Gregification/wm-top/enviroment/notes/resources.md

1. [How to setup the DDR configuration](https://wiki.st.com/stm32mpu/wiki/How_to_setup_the_DDR_configuration)
    - only how to apply configuraiton, no info on how to use DDR tool

1. [How to create your own machine](https://wiki.st.com/stm32mpu/wiki/How_to_create_your_own_machine)
