Gregification/wm-top/cad/kicad/ProcessorBoard_STM32MP153/related documents/IS43LD16320A-25BLI timing notes.pdf

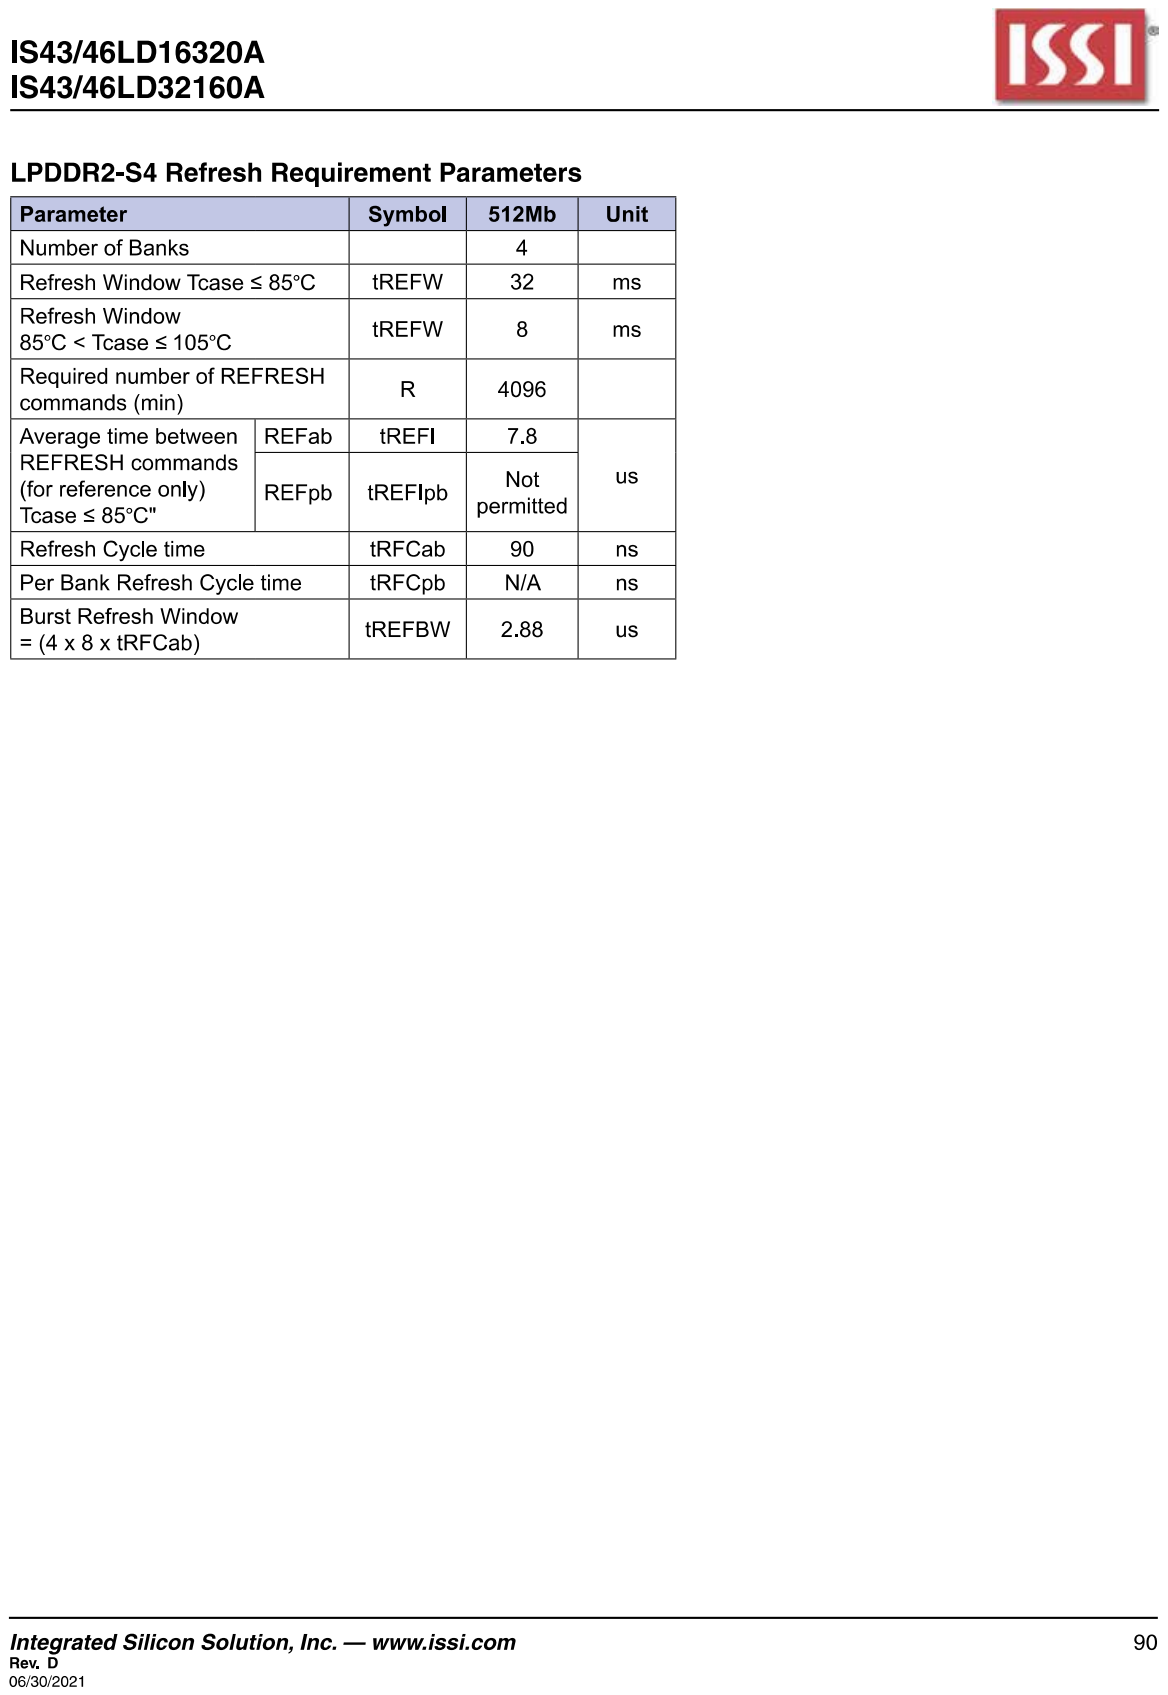
[picture p4: page 1]

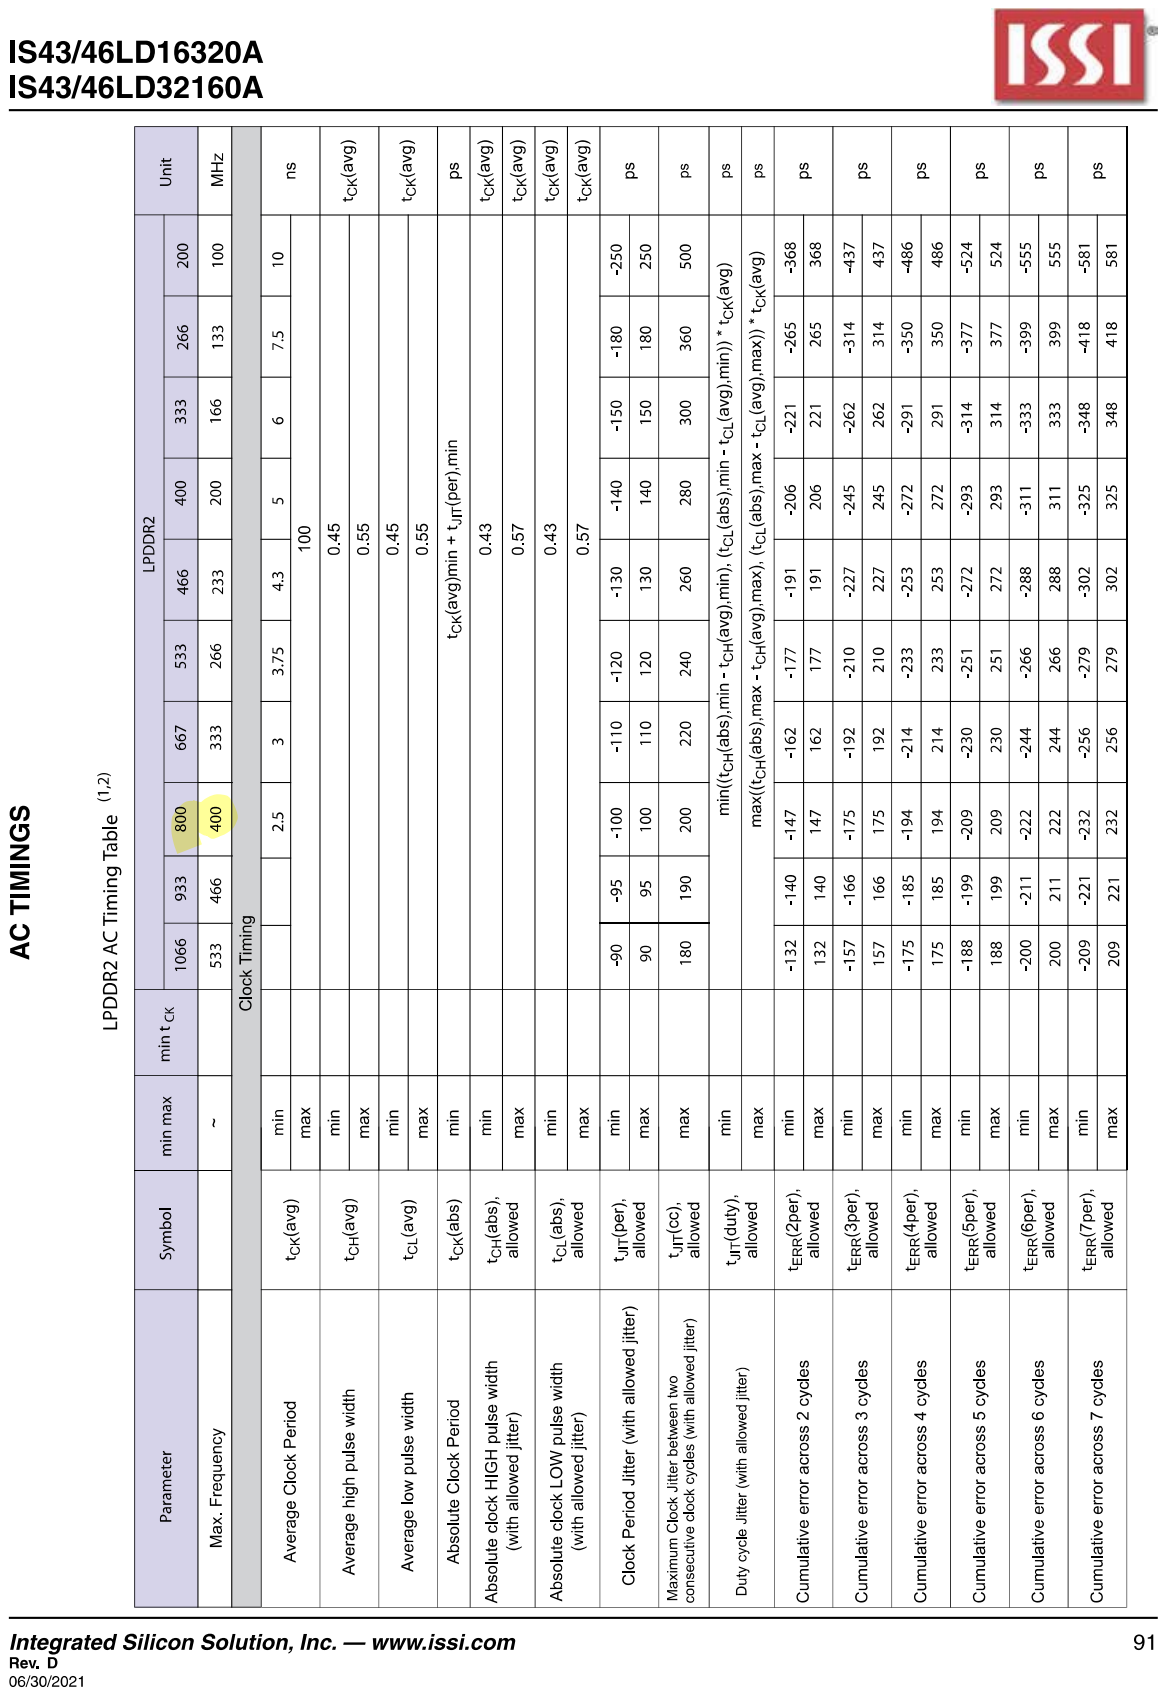
[picture p5: page 2]

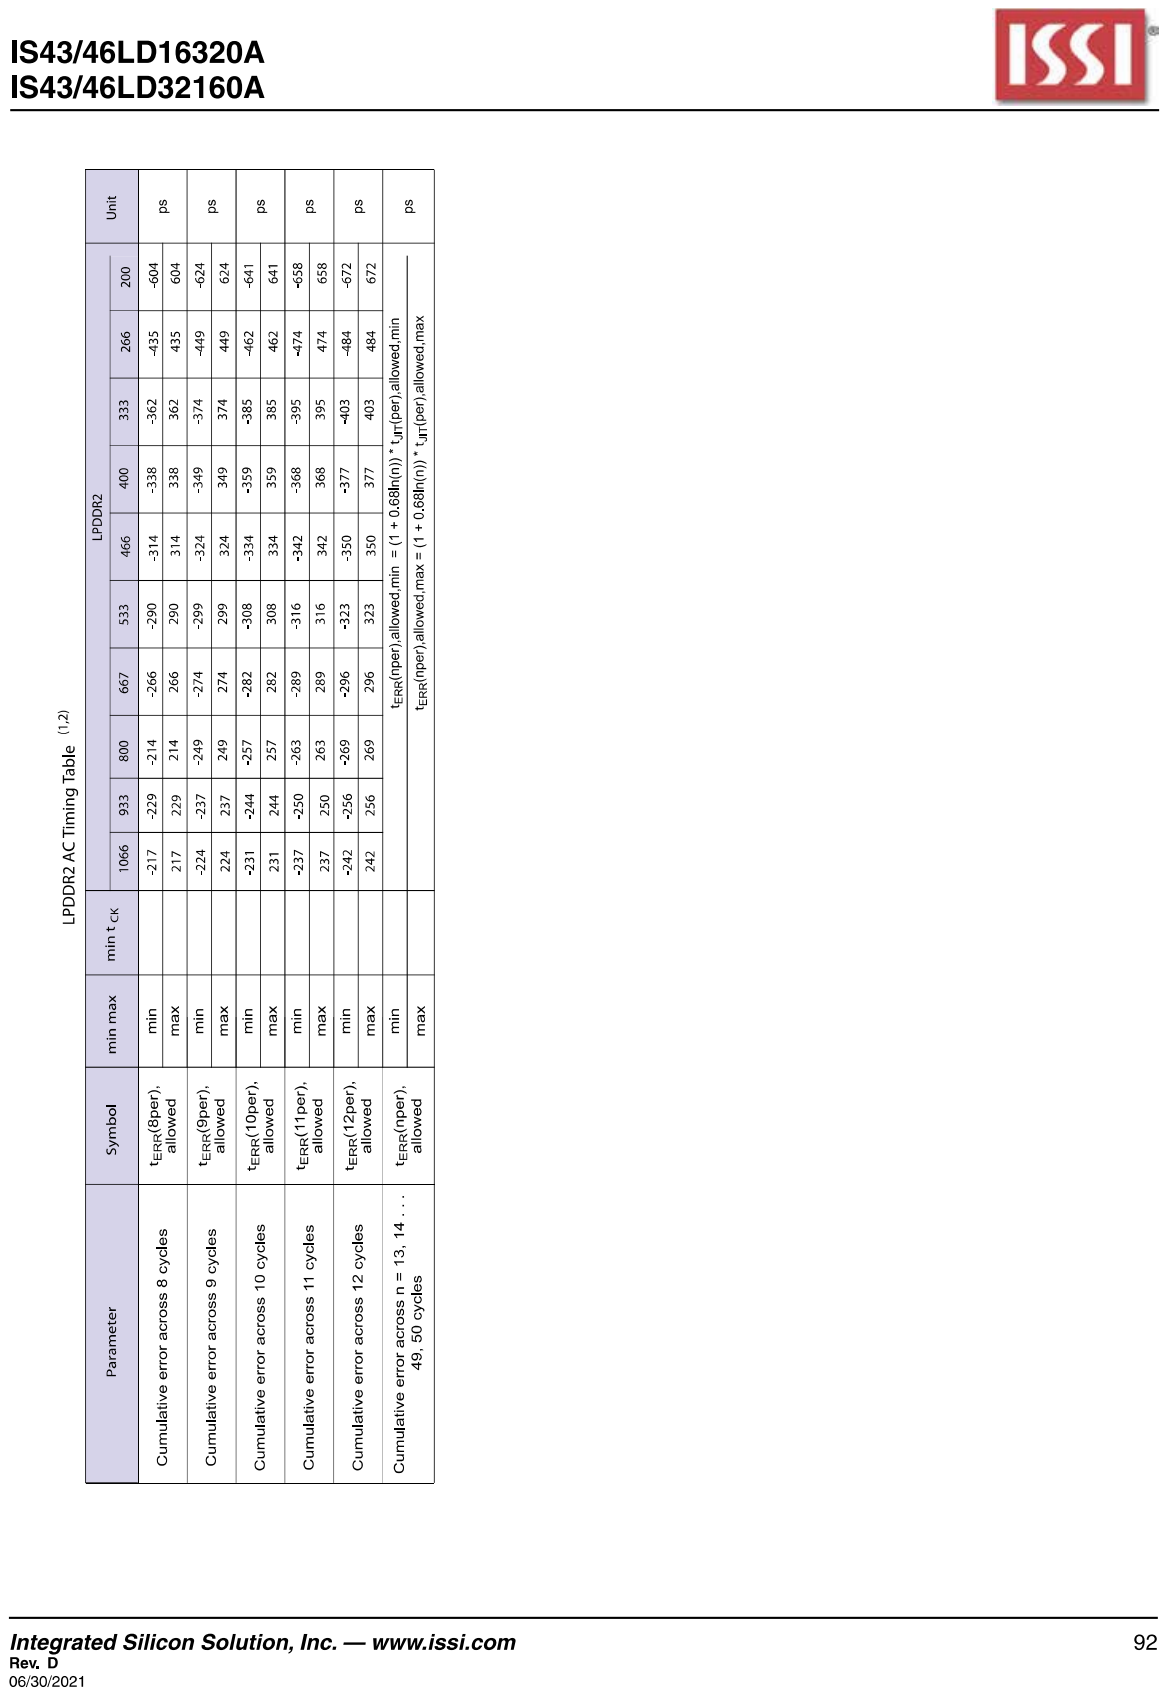
[picture p6: page 3]

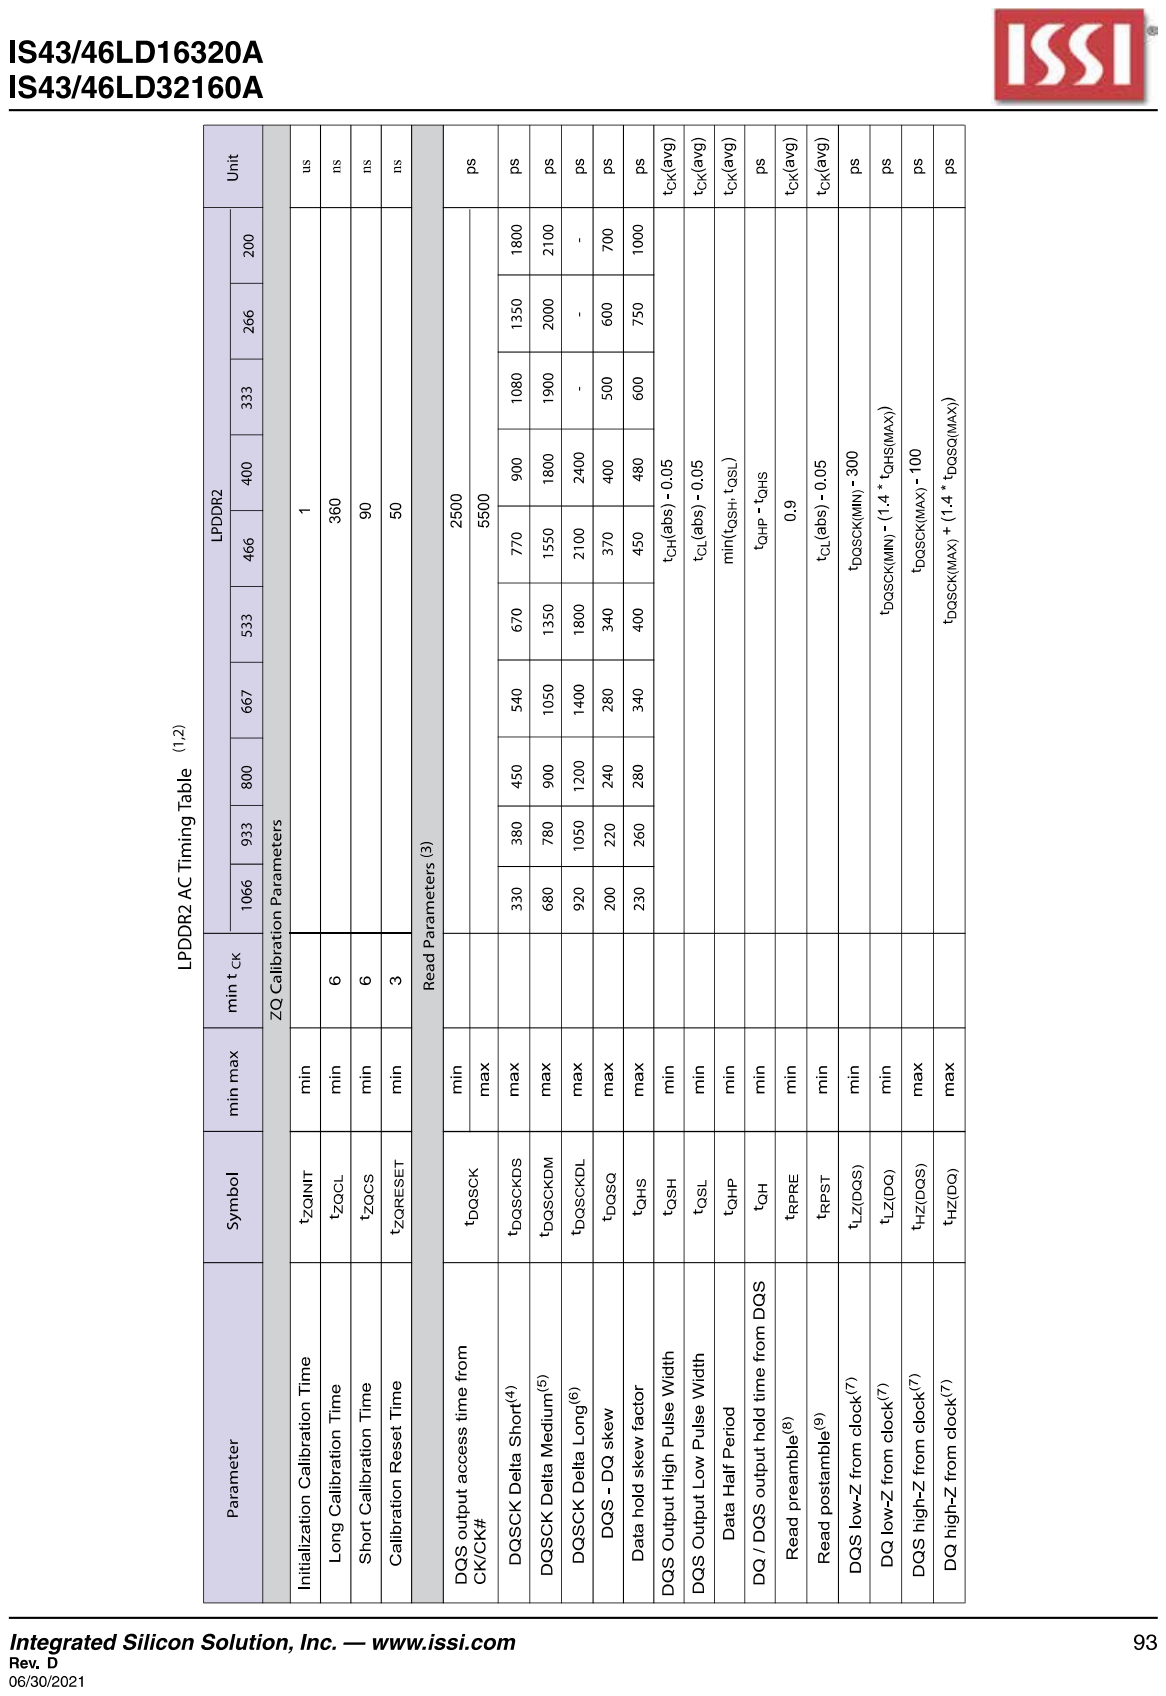
[picture p7: page 4]

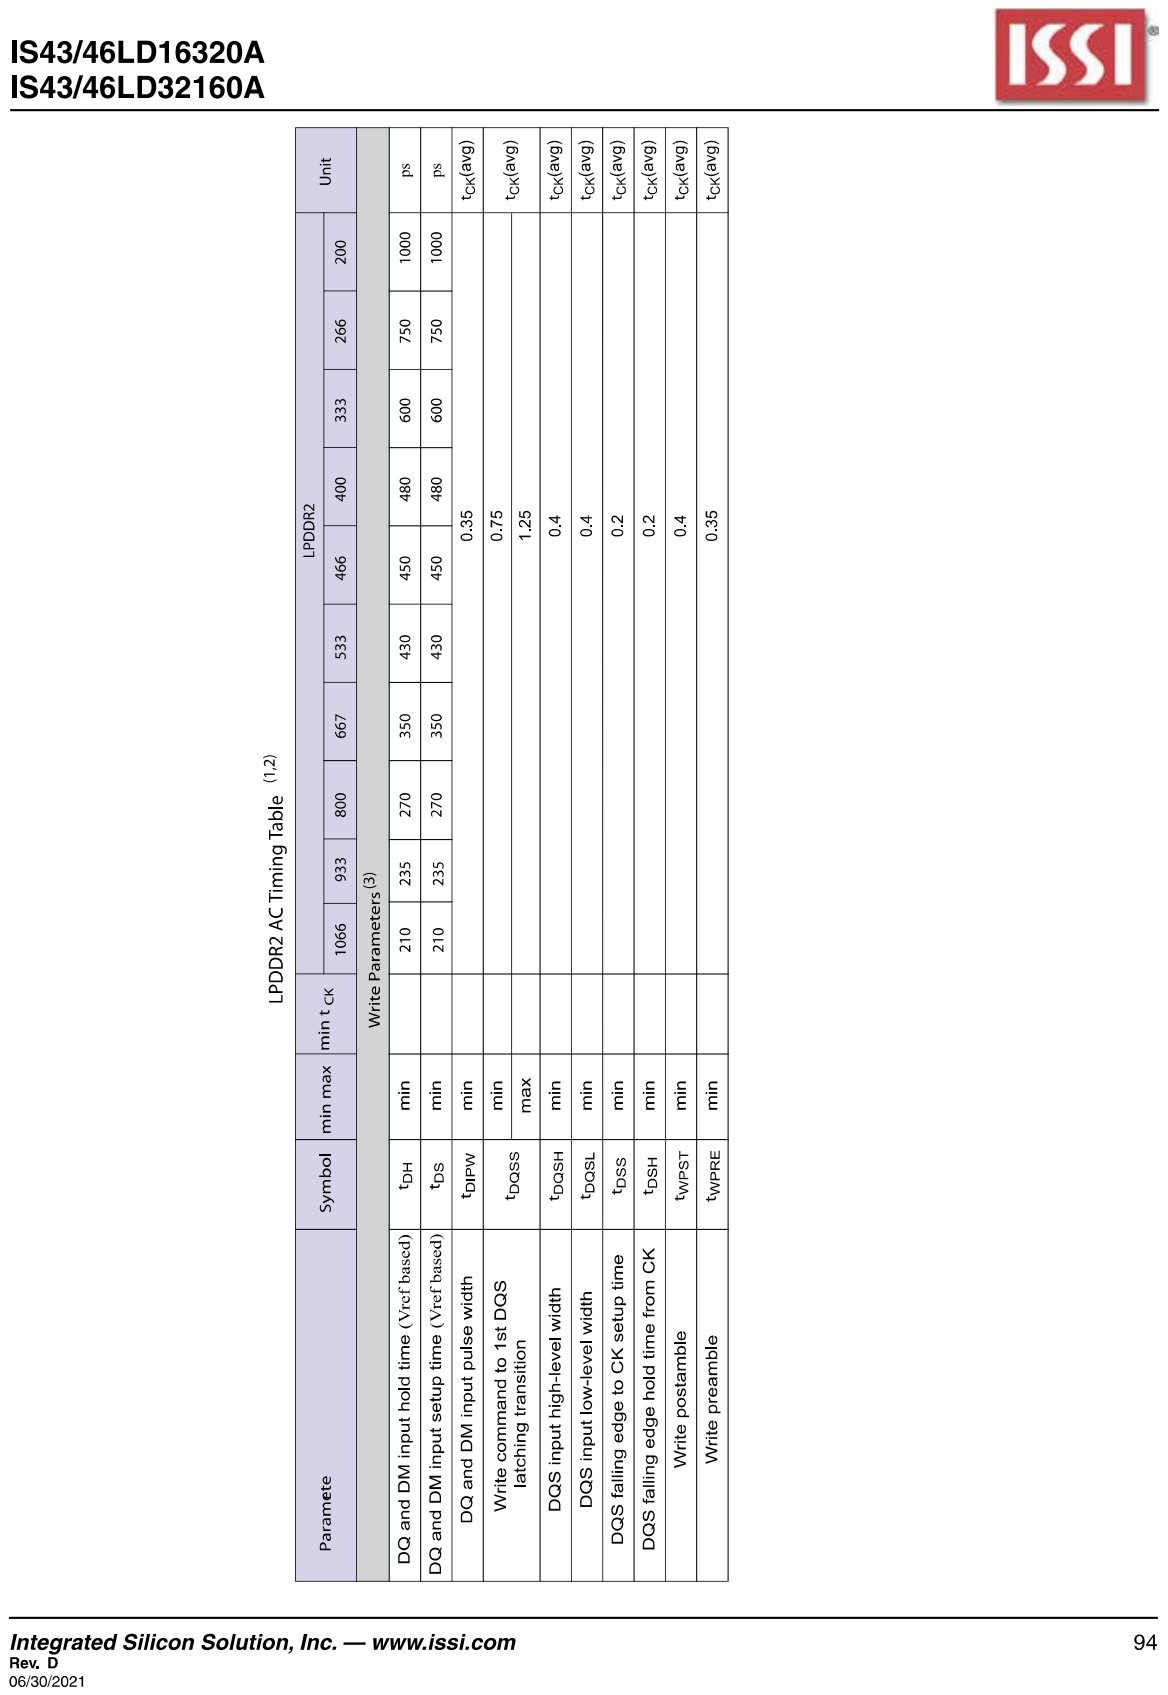
[picture p8: page 5]

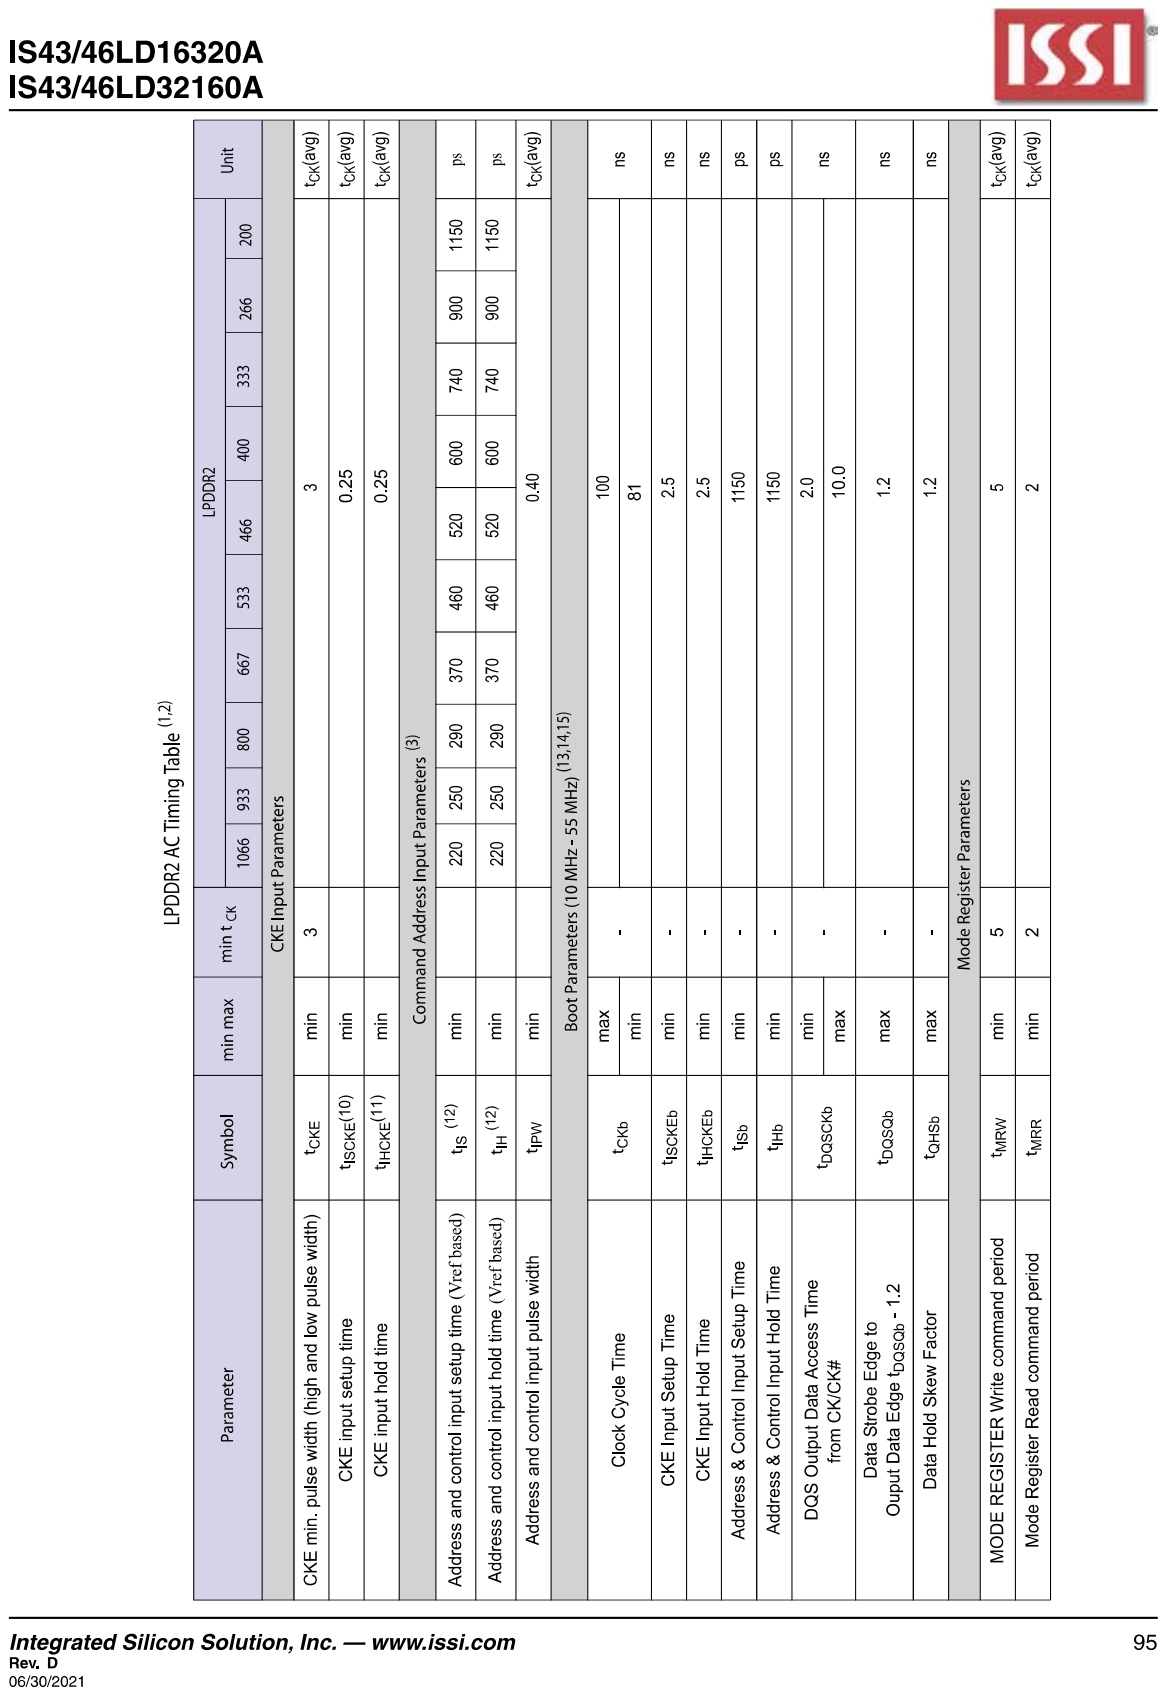
[picture p9: page 6]

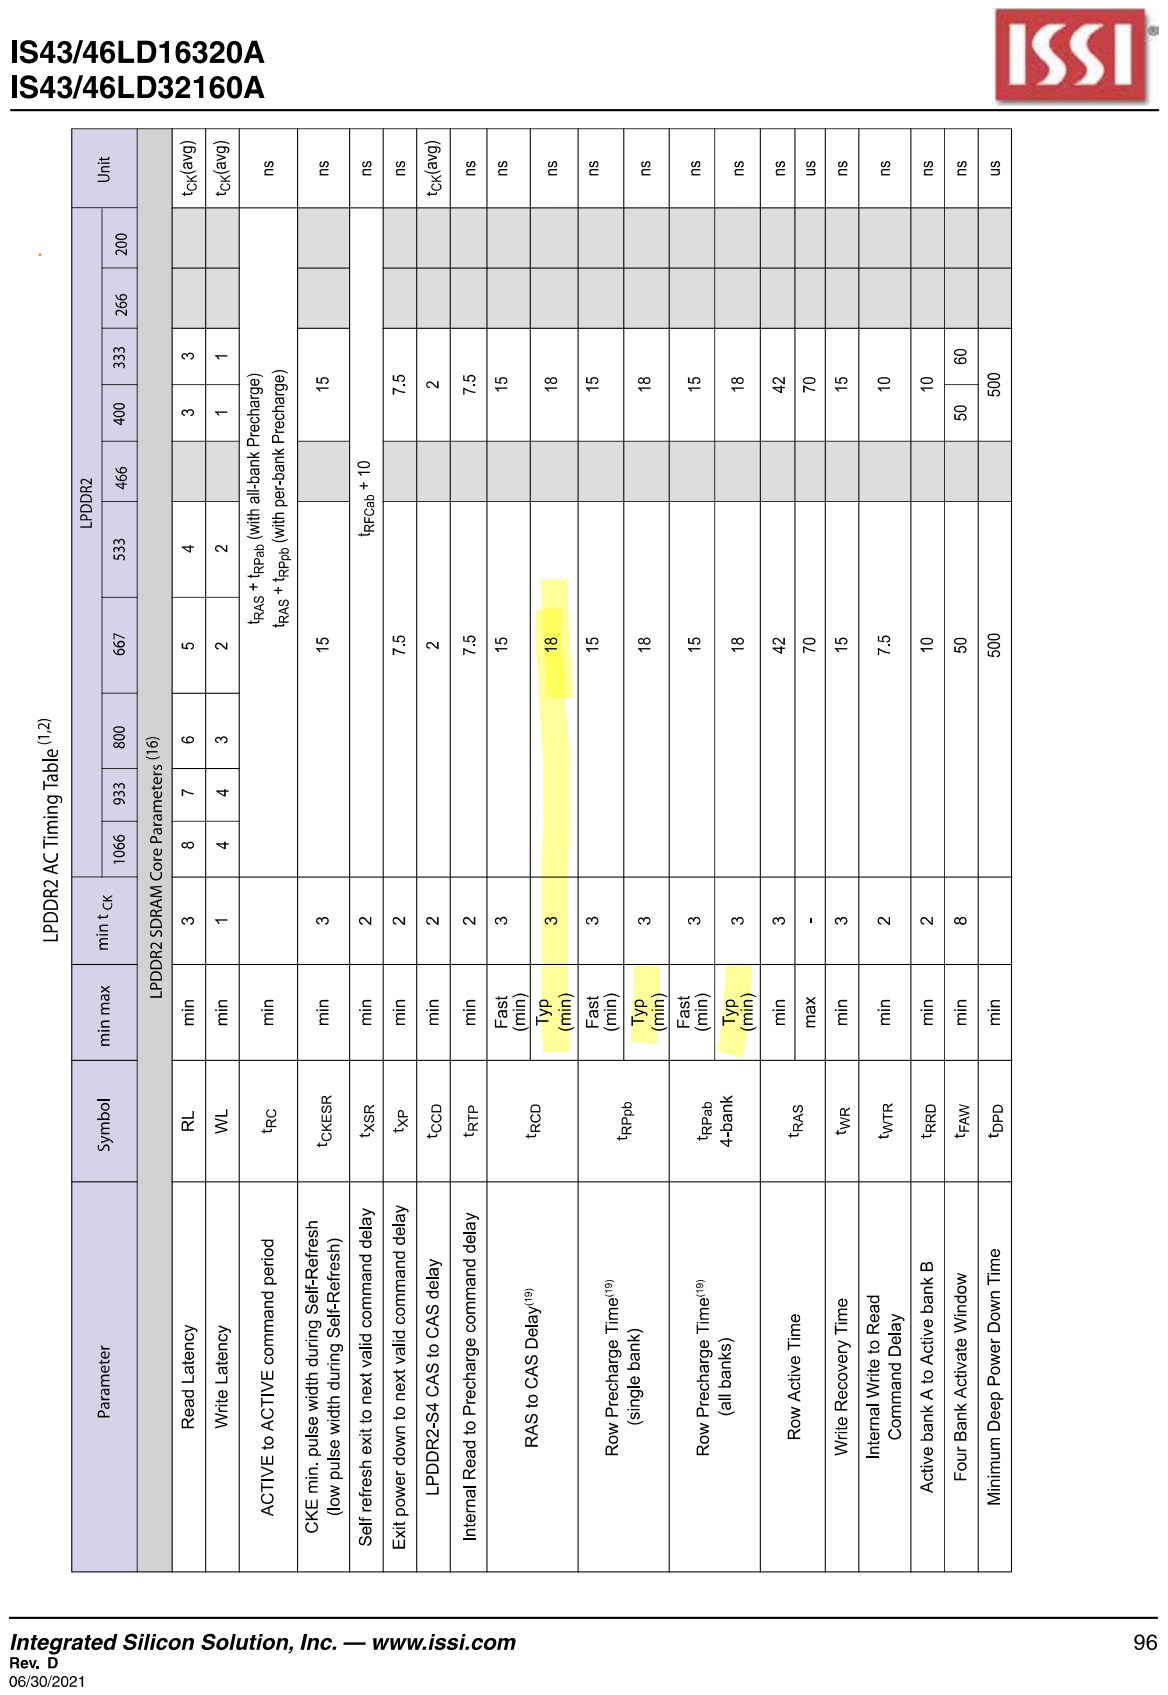
[picture p10: page 7]

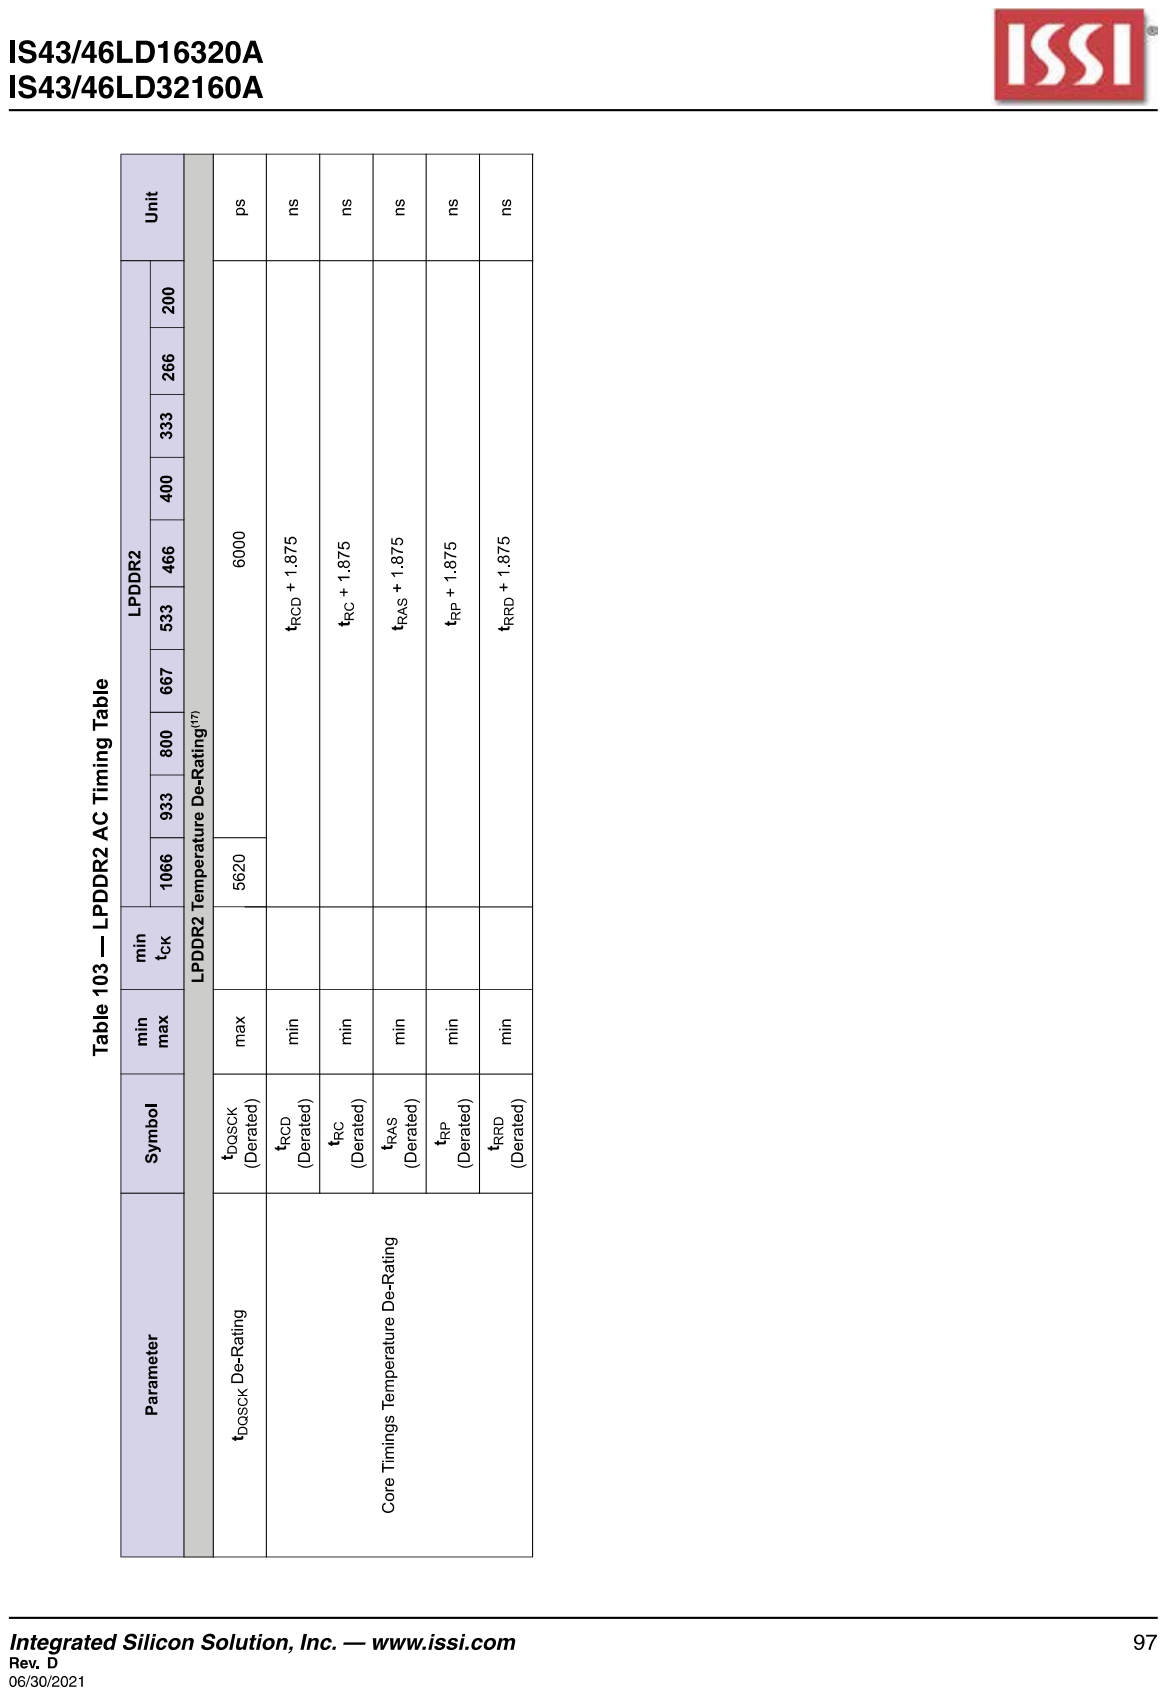
[picture p11: page 8]

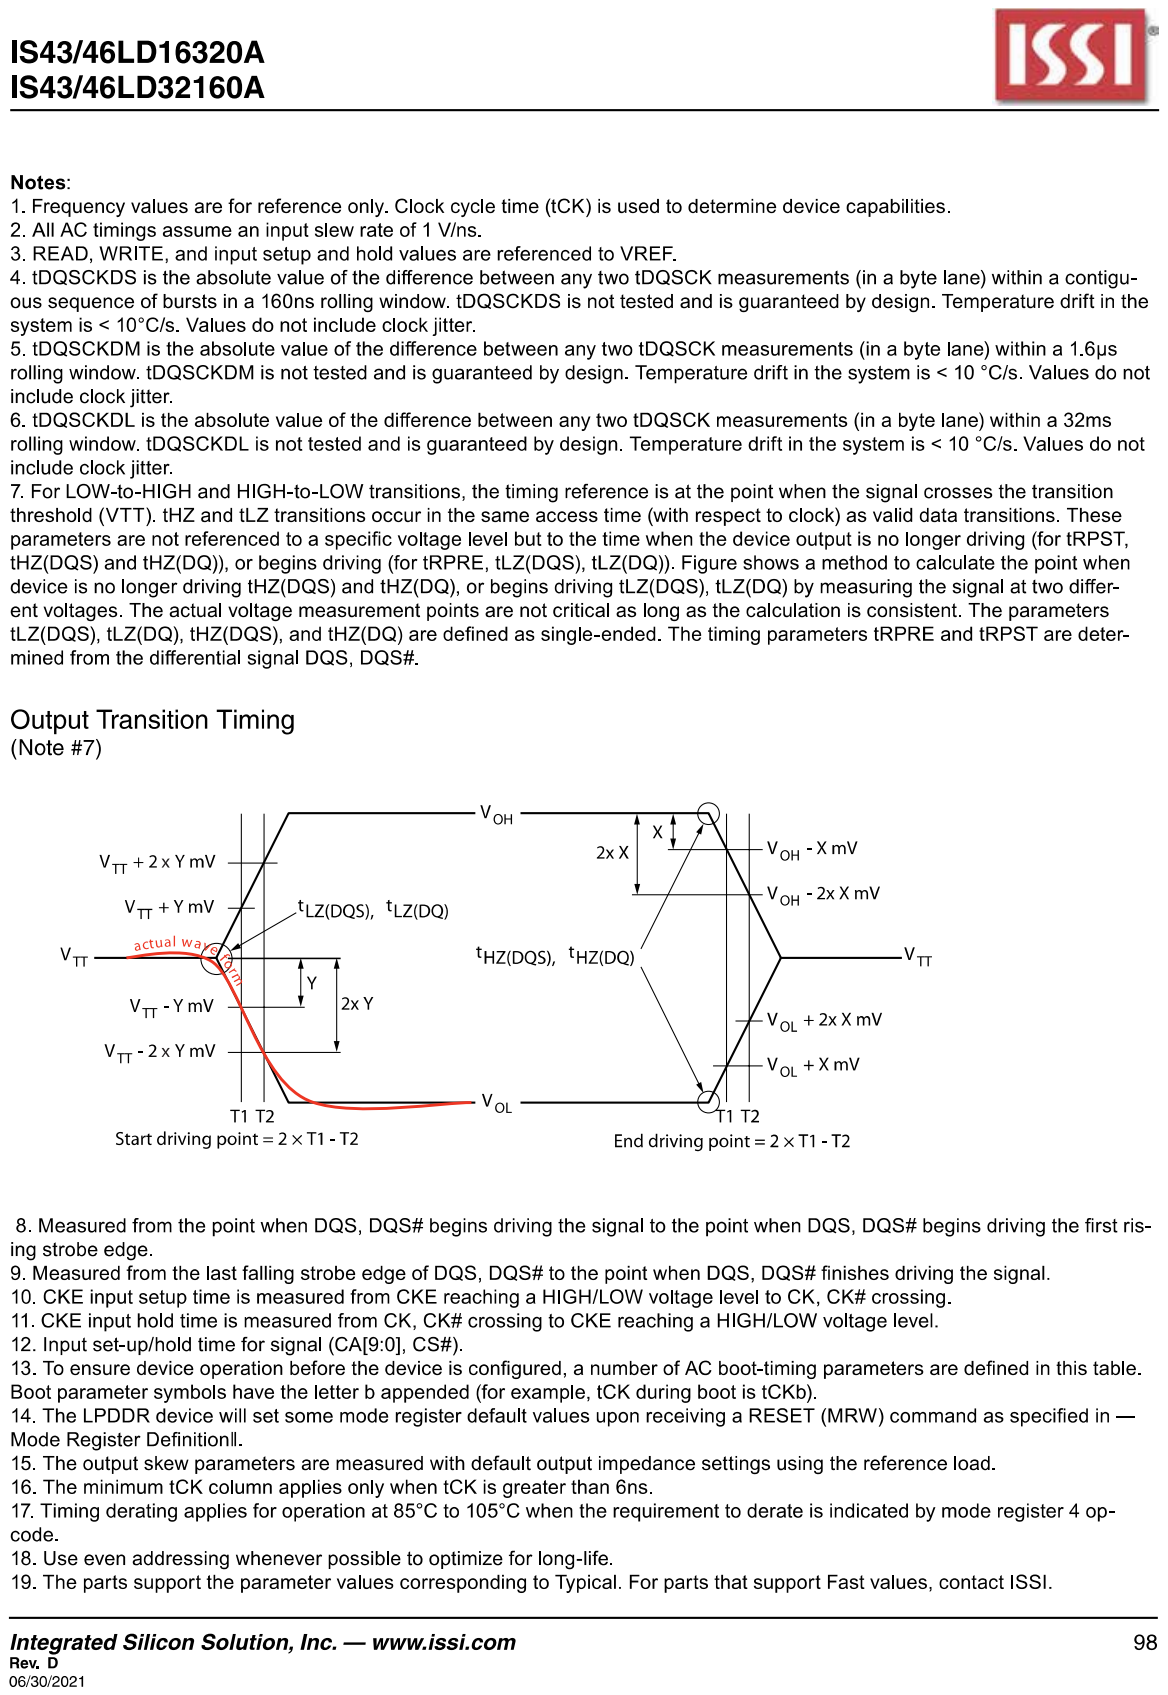
[picture p12: page 9]
