Gregification/wm-top/cad/kicad/ProcessorBoard_STM32MP153/ProcessorBoard_STM32MP153.kicad_pcb

## KiCad design cad/kicad/ProcessorBoard_STM32MP153/ProcessorBoard_STM32MP153.kicad_pcb (2026-11-11)

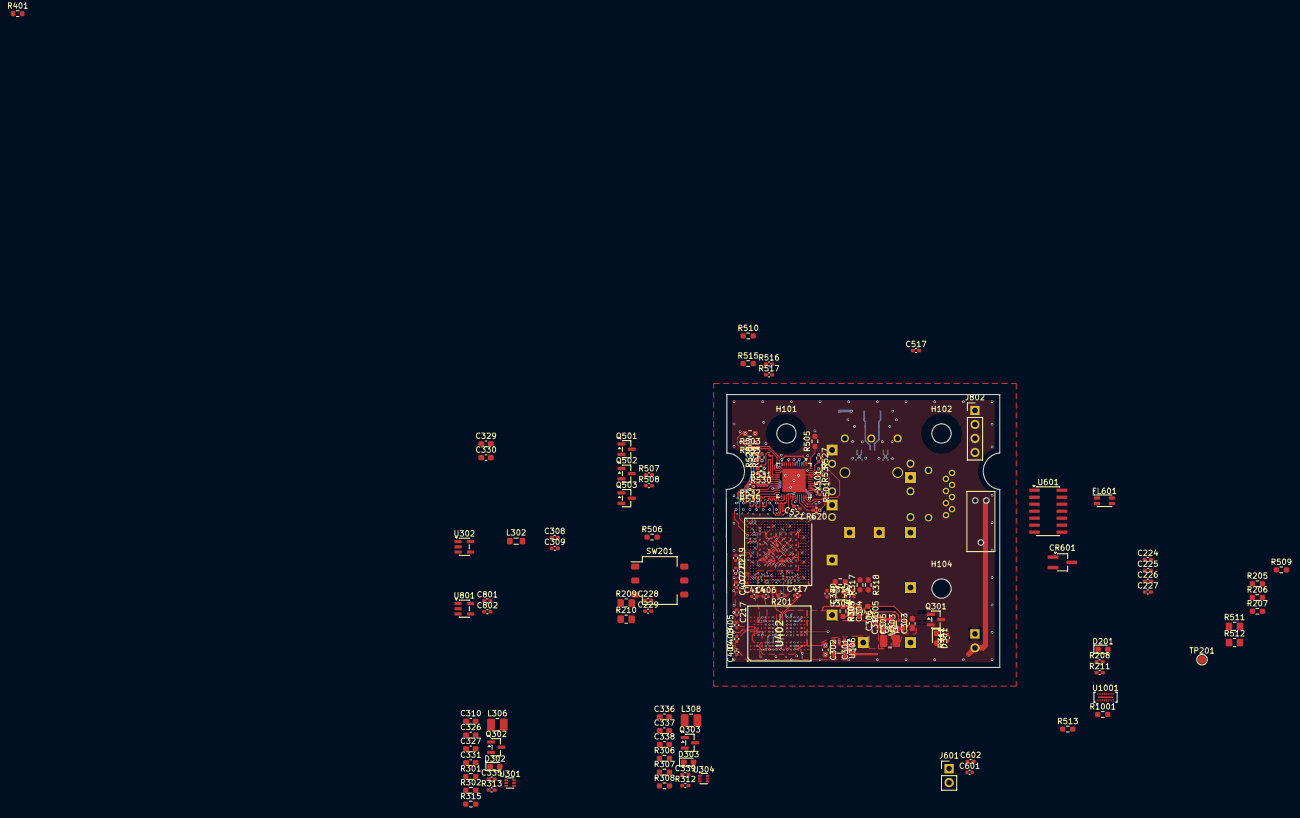
[picture p13: board ProcessorBoard_STM32MP153.kicad_pcb from above]

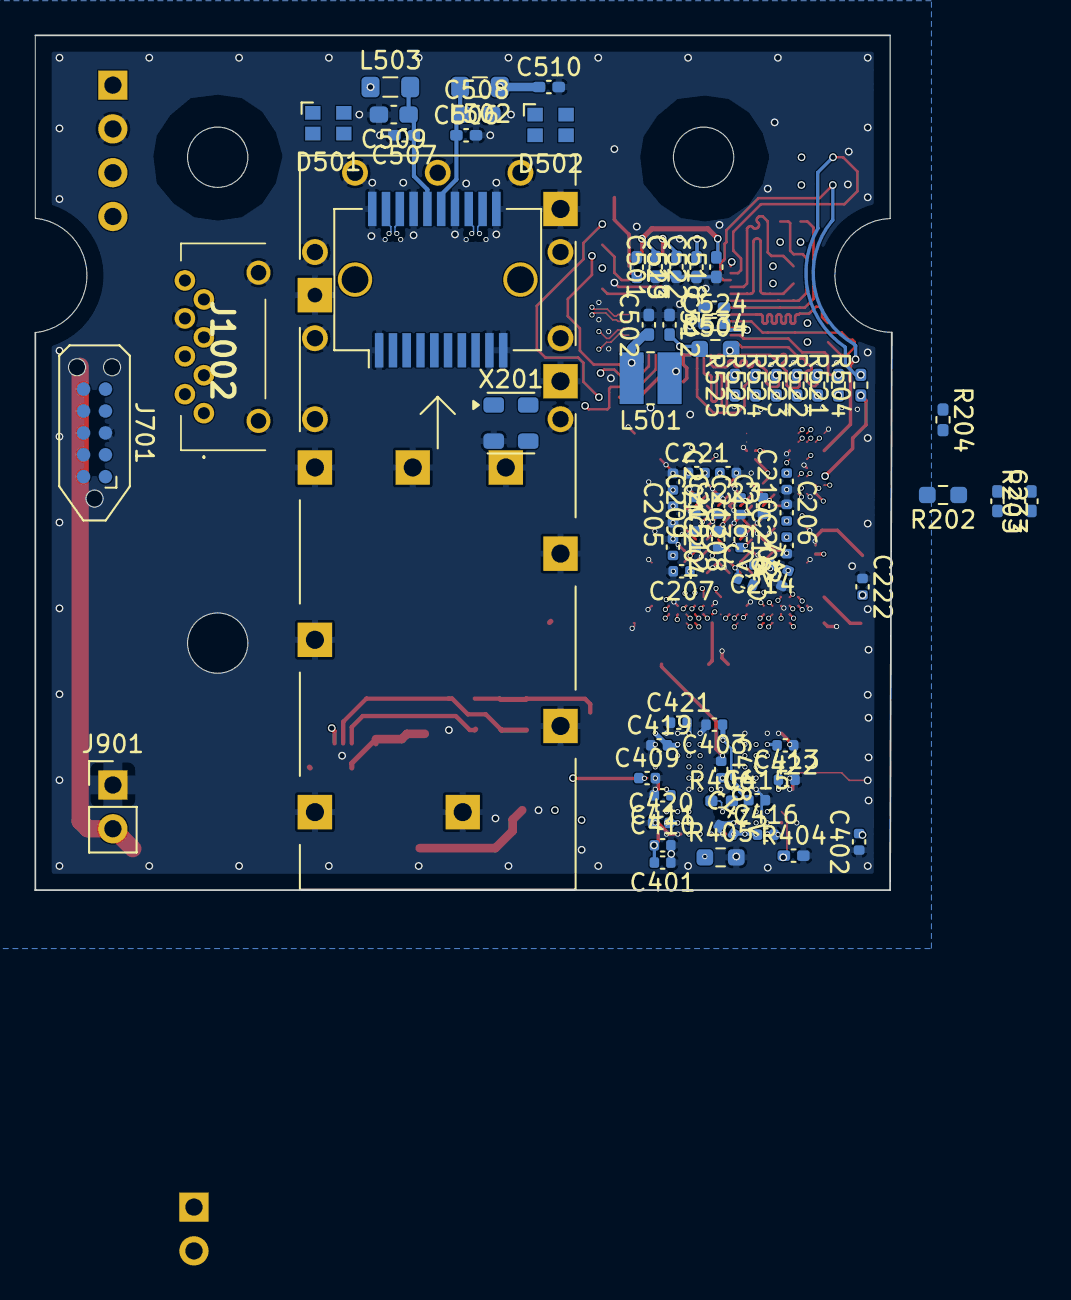
[picture p14: board ProcessorBoard_STM32MP153.kicad_pcb from below]

Board: 6 copper layers, 49.7 x 49.6 mm, 202 parts (74 on the bottom side), 162 nets.

Parts:
C201, C202, C204, C205, C206, C208, C209, C210, C211, C212, C213, C214, C215, C216, C217, C218, C219, C220, C221, C222, C223, C401, C402, C404, C405, C406, C412, C418, C419, C420, C421, C422, C601: 1u; C_0402_1005Metric
C203, C207, C403, C407, C408, C409, C410, C411, C413, C414, C415, C416, C417: 100n; C_0402_1005Metric
C224, C226, C233, C307, C340, C501, C506, C507, C510, C518, C519, C521, C522, C523, C524, C602: 100n; C_0402_1005Metric_Pad0.74x0.62mm_HandSolder
C225, C306, C308, C335, C339, C801, C802: 1u; C_0402_1005Metric_Pad0.74x0.62mm_HandSolder
C227, C309, C517: 1n; C_0402_1005Metric_Pad0.74x0.62mm_HandSolder
C228, C229, C502, C504, C512: 2.2u; C_0402_1005Metric_Pad0.74x0.62mm_HandSolder
C301, C302, C303, C326, C329, C330, C336, C338, C508, C509: 10u; C_0603_1608Metric_Pad1.08x0.95mm_HandSolder
C304, C331, C337: 22p; C_0603_1608Metric_Pad1.08x0.95mm_HandSolder
C305, C310, C311, C327: 22u; C_0603_1608Metric_Pad1.08x0.95mm_HandSolder
CR601: ESD2CAN36DBZRQ1; TSOT-23_HandSoldering
D201: red; LED_0603_1608Metric_Pad1.05x0.95mm_HandSolder
D301, D302, D303: green; LED_0603_1608Metric_Pad1.05x0.95mm_HandSolder
D501, D502: LED_ABGR; LED_ASMB-KTF0-0A306
FL601: Choke_CommonMode_FerriteCore_1243; L_CommonMode_Wurth_WE-CNSW-1206
H101, H102, H104: MountingHole; MountingHole_3.5mm
J501: SFP; Connector_SFP_and_Cage
J601, J901: Conn_01x02_Pin; PinHeader_1x02_P2.54mm_Vertical
J701: TC2050; Tag-Connect_TC2050-IDC-NL_2x05_P1.27mm_Vertical_with_bottom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
J802: Conn_01x04_Pin; PinHeader_1x04_P2.54mm_Vertical
J1002: PJS008U-3000-0; PJS008U30000
L301, L306, L308: 1u; L_1008_2520Metric_Pad1.43x2.20mm_HandSolder
L302, L502, L503: 1u; L_0805_2012Metric_Pad1.05x1.20mm_HandSolder
L501: 2.2u; L_Ferrocore_DLG-0302
Q301, Q302, Q303, Q501, Q502, Q503: MMBT5551L; SOT-23
R201, R404, R507, R508, R516, R517: 240; C_0402_1005Metric_Pad0.74x0.62mm_HandSolder
R202, R308, R314, R317, R318, R405, R509, R510, R1001: 10k; R_0603_1608Metric_Pad0.98x0.95mm_HandSolder
R203, R208, R211, R311, R312, R313: 1k; C_0402_1005Metric_Pad0.74x0.62mm_HandSolder
R204: 10; R_0402_1005Metric_Pad0.72x0.64mm_HandSolder
R205, R206, R207, R301, R302, R303, R304, R305, R306, R307, R315: 45.3k; R_0603_1608Metric_Pad0.98x0.95mm_HandSolder
R209, R210: 1M; R_0805_2012Metric_Pad1.20x1.40mm_HandSolder
R401: JMPR; R_0603_1608Metric
R406: 100; R_0402_1005Metric_Pad0.72x0.64mm_HandSolder
R501: 100; R_0402_1005Metric
R503, R513, R533, R534: 3090; R_0603_1608Metric_Pad0.98x0.95mm_HandSolder
R504, R521, R522, R523, R524, R525, R526, R527, R528, R529, R530, R531, R532, R535, R537: 22; R_0402_1005Metric_Pad0.72x0.64mm_HandSolder
R505: 2.49k; R_0603_1608Metric_Pad0.98x0.95mm_HandSolder
R506, R515: 330; R_0603_1608Metric_Pad0.98x0.95mm_HandSolder
R511, R512: 5.6k; R_0805_2012Metric_Pad1.20x1.40mm_HandSolder
R520: 0; R_0402_1005Metric_Pad0.72x0.64mm_HandSolder
SW201: SW_DIP_x03; SW_DIP_SPSTx03_Slide_Omron_A6S-310x_W8.9mm_P2.54mm
TP201: TestPoint; TestPoint_Pad_D1.5mm
U201: STM32MP153CACx; ST_TFBGA-361_12x12mm_Layout23x23_P0.5mmP0.65mm
U301, U303, U304: SOT-563
U302, U801: TLV77333; SOT-23-5
U305: TLV9001IDCK; SOT-353_SC-70-5
U306: TLV77318; SOT-23-5
U402: W97AH6NBVAxx; BGA134C65P10X17_1000X1150X110
U601: TJA1448A; SO-14_3.9x8.65mm_P1.27mm
U1001: EMIF06-MSD02N16; ST MICRO QFN 3.5x1.2 16L 17
X201: ECS-3225MVQ-240-CN-TR; CDFN-4_2.5x3.2mm_P2.1mm
X501: RTL8211FS(I)-xx-xx; QFN-48-1EP_6x6mm_P0.4mm_EP4.2x4.2mm

Connections:
/MPU/Boot0: R207.2, SW201.1, U201.N1 (BOOT0)
/MPU/Boot1: R206.2, SW201.2, U201.N4 (BOOT1)
/MPU/Boot2: R205.2, SW201.3, U201.M2 (BOOT2)
/MPU/OSC_HSE_in: U201.P1 (RCC_OSC_IN), X201.3 (OUT)
/MPU/OSC_HSE_out: R203.1, U201.P2 (RCC_OSC_OUT)
/PWR_ON: R202.1, R209.1, R210.1, U201.R2 (PWR_ON), U301.4 (EN), U303.4 (EN), U304.4 (EN), U306.3 (EN)
/SDMCC1.CK: U201.D13 (SDMMC1_CK), U1001.6 (CLK_In)
/SDMCC1.CMD: U201.D12 (SDMMC1_CMD), U1001.5 (CMD_In)
/SDMCC1.D0: U201.D18 (SDMMC1_D0), U1001.7 (DAT0_In)
/SDMCC1.D1: U201.D17 (SDMMC1_D1), U1001.8 (DAT1_In)
/SDMCC1.D2: U201.D15 (SDMMC1_D2), U1001.3 (DAT2_In)
/SDMCC1.D3: U201.D16 (SDMMC1_D3), U1001.4 (DAT3_In)
/SFP/3v3: D501.1 (A), D502.1 (A)
/SFP/LED_{0}: Q503.1 (B), X501.35 (PHYAD_{0})
/SFP/LED_{1}: Q502.1 (B), R513.1, X501.36 (CFG_LDO_{0})
/SFP/LED_{2}: Q501.1 (B), X501.37 (CFG_LDO_{1})
/SFP/SERDES_I_N: J501.12 (RD-), R501.1, X501.39 (HS_I_N)
/SFP/SERDES_I_P: J501.13 (RD+), R501.2, X501.38 (HS_I_P)
/SFP/SERDES_O_N: J501.19 (TD-), X501.41 (HS_O_N)
/SFP/SERDES_O_P: J501.18 (TD+), X501.40 (HS_O_P)
/SFP/V_{ccR}: C506.1, C508.1, J501.15 (VccR), L502.2
/SFP/V_{ccT}: C507.1, C509.1, J501.16 (VccT), L503.2, R509.1, R510.1
/SFP/ir_1v0: C502.1, C504.1, C519.2, C522.2, C523.2, C524.2, L501.2, X501.4 (AV_{dd}1v0), X501.9 (AV_{dd}1v0), X501.22 (DV_{dd}1v0), X501.47 (AV_{dd}1v0)
/SFP/ir_out: L501.1, X501.32 (REG_OUT)
/V_{DDR_ref}: C224.1, C340.1, C403.1, C407.1, C415.1, C417.1, R314.2, R401.1, R401.2, U201.AC20 (DDR_VREF), U305.4, U402.G3 (VREF(CA)), U402.J9 (VREF(DQ))
/V_{ddA_ADC}: C308.1, C309.1, L302.1, U201.1H1 (VDDA)
/V_{ddA}_1v8: C229.2, U201.AB14 (VDDA1V8_REG), U801.3 (EN)
/V_{dd_DDR1}_1v8: C302.1, C401.2, C402.2, C404.2, C408.1, C409.1, C410.1, U306.5 (OUT), U402.B6 (VDD1), U402.C1 (VDD1), U402.R1 (VDD1), U402.T6 (VDD1)
/V_{dd_DDRQ}_1v2: C203.1, C204.2, C207.1, C208.2, C211.2, C214.2, C217.2, C220.2, C222.2, C304.1, C305.1, C306.1, C311.1, C405.2, C406.2, C411.1, C412.2, C413.1, C414.1, C416.1, C418.2, C419.2, C420.2, C421.2, C422.2, L301.1, R303.2, R304.1, R317.1, U201.1A8 (VDDQ_DDR), U201.1B7 (VDDQ_DDR), U201.1B9 (VDDQ_DDR), U201.1C8 (VDDQ_DDR), U201.1D9 (VDDQ_DDR), U201.1E8 (VDDQ_DDR), U201.1F9 (VDDQ_DDR), U201.1G8 (VDDQ_DDR), U201.1H9 (VDDQ_DDR), U201.1J8 (VDDQ_DDR), U402.B5 (VDD2), U402.C7 (VDDQ), U402.C10 (VDDQ), U402.D2 (VDD2), U402.D5 (VDDQ), U402.E9 (VDDQ), U402.F1 (VDDCA), U402.F10 (VDDQ), U402.G1 (VDD2), U402.H1 (VDDCA), U402.H6 (VDDQ), U402.J6 (VDDQ), U402.J7 (VDD2), U402.K6 (VDDQ), U402.M10 (VDDQ), U402.N2 (VDDCA), U402.N9 (VDDQ), U402.P2 (VDD2), U402.P5 (VDDQ), U402.R7 (VDDQ), U402.R10 (VDDQ), U402.T5 (VDD2)
/V_{dd_IO}_3v3: C202.2, C206.2, C210.2, C213.2, C216.2, C219.2, C330.1, L302.2, R204.1, R208.1, U201.1F1 (VBAT), U201.1F3 (VDD), U201.1G2 (VDD_ANA), U201.1G4 (VDD), U201.1H3 (VDD), U201.1H5 (VDD), U201.1J2 (VDD), U201.1J4 (VDD), U201.1J6 (VDD), U201.R3 (PDR_ON), U201.T3 (PDR_ON_CORE), U302.5 (OUT)
/V_{dd_USB}_3v3: C801.1, C802.1, U201.AA15 (VDD3V3_USBHS), U201.AA17 (VDD3V3_USBFS), U801.5 (OUT)
/V_{dd_board}_3v3: C337.1, C338.1, C339.1, C501.2, C510.1, C512.2, C517.2, C518.2, C521.2, C602.1, D201.2 (A), J1002.4 (Vdd), L308.1, L502.1, L503.1, R306.2, R307.1, R503.1, R511.2, R512.1, R533.1, R534.1, R1001.2, U601.11 (VIO), U1001.15 (Vcc), U1001.16 (DAT3_pull_-up), X501.1 (AV_{dd}3v3), X501.12 (AV_{dd}3v3), X501.29 (DV_{dd}_RG), X501.30 (DV_{dd}3v3), X501.31 (V_{dd}_REG)
/V_{dd_core}_1v2: C201.2, C205.2, C209.2, C212.2, C215.2, C218.2, C221.2, C223.2, C310.1, C327.1, C331.1, C335.1, L306.1, R301.1, R315.2, U201.1A2 (VDDCORE), U201.1A4 (VDDCORE), U201.1A6 (VDDCORE), U201.1B1 (VDDCORE), U201.1B3 (VDDCORE), U201.1B5 (VDDCORE), U201.1C2 (VDDCORE), U201.1C4 (VDDCORE), U201.1C6 (VDDCORE), U201.1D1 (VDDCORE), U201.1D3 (VDDCORE), U201.1D5 (VDDCORE), U201.1D7 (VDDCORE), U201.1E2 (VDDCORE), U201.1E4 (VDDCORE), U201.1E6 (VDDCORE), U201.1F5 (VDDCORE), U201.1F7 (VDDCORE), U201.1G6 (VDDCORE), U201.1H7 (VDDCORE)
/ddr.CKE: R405.1, U201.T20 (DDR_CKE), U402.K1 (CKE0)
/ddr.CLK_N: R406.2, U201.N23 (DDR_CLKN), U402.H3 (CK_c)
/ddr.CLK_P: R406.1, U201.N22 (DDR_CLKP), U402.J3 (CK_t)
/ddr.CSn: U201.M22 (DDR_CSN), U402.L1 (CS0_n)
/ddr.a0: U201.L20 (DDR_A0), U402.P3 (CA0)
/ddr.a1: U201.P22 (DDR_A1), U402.N3 (CA1)
/ddr.a2: U201.J20 (DDR_A2), U402.M3 (CA2)
/ddr.a3: U201.K22 (DDR_A3), U402.M2 (CA3)
/ddr.a4: U201.V20 (DDR_A4), U402.M1 (CA4)
/ddr.a5: U201.H20 (DDR_A5), U402.G2 (CA5)
/ddr.a6: U201.W20 (DDR_A6), U402.F2 (CA6)
/ddr.a7: U201.E20 (DDR_A7), U402.F3 (CA7)
/ddr.a8: U201.Y20 (DDR_A8), U402.E3 (CA8)
/ddr.a9: U201.G20 (DDR_A9), U402.E2 (CA9)
/ddr.d0: U201.E22 (DDR_DQ0), U402.N8 (DQ0)
/ddr.d1: U201.F22 (DDR_DQ1), U402.M8 (DQ1)
/ddr.d2: U201.H21 (DDR_DQ2), U402.M7 (DQ2)
/ddr.d3: U201.E21 (DDR_DQ3), U402.M9 (DQ3)
/ddr.d4: U201.J21 (DDR_DQ4), U402.M6 (DQ4)
/ddr.d5: U201.J22 (DDR_DQ5), U402.L7 (DQ5)
/ddr.d6: U201.H22 (DDR_DQ6), U402.L8 (DQ6)
/ddr.d7: U201.G21 (DDR_DQ7), U402.L9 (DQ7)
/ddr.d8: U201.T21 (DDR_DQ8), U402.G7 (DQ10)
/ddr.d9: U201.U21 (DDR_DQ9), U402.G9 (DQ8)
/ddr.d10: U201.T22 (DDR_DQ10), U402.E8 (DQ15)
/ddr.d11: U201.W21 (DDR_DQ11), U402.F8 (DQ14)
/ddr.d12: U201.W23 (DDR_DQ12), U402.F6 (DQ11)
/ddr.d13: U201.T23 (DDR_DQ13), U402.F7 (DQ13)
/ddr.d14: U201.W22 (DDR_DQ14), U402.F9 (DQ12)
/ddr.d15: U201.Y21 (DDR_DQ15), U402.G8 (DQ9)
/ddr.m0: U201.H23 (DDR_DQM0), U402.K5 (DM0)
/ddr.m1: U201.V22 (DDR_DQM1), U402.H5 (DM1)
/ddr.s0_N: U201.G23 (DDR_DQS0N), U402.L5 (DQS0_c)
/ddr.s0_P: U201.G22 (DDR_DQS0P), U402.L6 (DQS0_t)
/ddr.s1_N: U201.U23 (DDR_DQS1N), U402.G5 (DQS1_c)
/ddr.s1_P: U201.U22 (DDR_DQS1P), U402.G6 (DQS1_t)
/jtag_tc2050.TCK: J701.4, U201.B20 (JTCK)
/jtag_tc2050.TDI: J701.8, U201.A20 (JTDI)
/jtag_tc2050.TDO: J701.6, U201.A19 (JTDO)
/jtag_tc2050.TMS: J701.2, U201.C20 (JTMS)
/jtag_tc2050.nSRST: C226.1, C227.1, J701.10, U201.M3 (NRST)
/jtag_tc2050.nTRST: J701.9, U201.B19 (NJTRST)
/offboard5v: C301.1, C303.1, C326.1, C329.1, C336.1, C601.2, J901.2, R311.1, R312.1, R313.1, U301.3 (V_{in}), U302.1 (IN), U302.3 (EN), U303.3 (V_{in}), U304.3 (V_{in}), U305.5 (V+), U306.1 (IN), U601.3 (VCC), U801.1 (IN)
/sfp.SCL: J501.5 (MOD_DEF1), R512.2
/sfp.SDA: J501.4 (MOD_DEF2), R511.1
/sfp.macphy_clk_25: R520.1, R527.1, U201.Y8 (ETH1_CLK)
/sfp.mdc: R504.1, U201.AA6 (ETH1_MDC)
/sfp.mdio: R533.2, U201.AC3 (ETH1_MDIO), X501.15 (MDIO)
/sfp.module.rx_loss: J501.8 (RX_LOS), R510.2
/sfp.module.tx_fault: J501.2 (TX_FAULT), R509.2
/sfp.phy.int#: U201.K4 (ETH1_PHY_INTN), X501.34 (INTB/PMEB)
/sfp.phymac_frclk_125: R537.1, U201.Y6 (ETH1_CLK125)
/sfp.rxc: R526.1, U201.AA4 (ETH1_RX_CLK)
/sfp.rxctl: R525.1, U201.AB8 (ETH1_RX_CTL)
/sfp.rxd0: R524.1, U201.AC7 (ETH1_RXD0)
/sfp.rxd1: R523.1, U201.AB7 (ETH1_RXD1)
/sfp.rxd2: R522.1, U201.Y11 (ETH1_RXD2)
/sfp.rxd3: R521.1, U201.W4 (ETH1_RXD3)
/sfp.txc: R535.1, U201.AB2 (ETH1_GTX_CLK)
/sfp.txctl: R532.1, U201.Y7 (ETH1_TX_CTL)
/sfp.txd0: R528.1, U201.AA2 (ETH1_TXD0)
/sfp.txd1: R529.1, U201.AA1 (ETH1_TXD1)
/sfp.txd2: R530.1, U201.Y2 (ETH1_TXD2)
/sfp.txd3: R531.1, U201.Y1 (ETH1_TXD3)
GND: C201.1, C202.1, C203.2, C204.1, C205.1, C206.1, C207.2, C208.1, C209.1, C210.1, C211.1, C212.1, C213.1, C214.1, C215.1, C216.1, C217.1, C218.1, C219.1, C220.1, C221.1, C222.1, C223.1, C224.2, C225.1, C226.2, C228.1, C229.1, C233.2, C301.2, C302.2, C303.2, C305.2, C306.2, C307.2, C308.2, C309.2, C310.2, C311.2, C326.2, C327.2, C329.2, C330.2, C335.2, C336.2, C338.2, C339.2, C340.2, C401.1, C402.1, C403.2, C404.1, C405.1, C406.1, C407.2, C408.2, C409.2, C410.2, C411.2, C412.1, C413.2, C414.2, C415.2, C416.2, C417.2, C418.1, C419.1, C420.1, C421.1, C422.1, C501.1, C502.2, C504.2, C506.2, C507.2, C508.2, C509.2, C510.2, C512.1, C517.1, C518.1, C519.1, C521.1, C522.1, C523.1, C524.1, C601.1, C602.2, C801.2, C802.2, CR601.3, J501.1 (VeeT), J501.9 (VeeR), J501.10 (VeeR), J501.11 (VeeR), J501.14 (VeeR), J501.17 (VeeT), J501.20 (VeeT), J501.CAGE, J701.3, J802.2, J901.1, J1002.6 (Vss), J1002.MH1, J1002.MH2, Q301.2 (E), Q302.2 (E), Q303.2 (E), Q501.2 (E), Q502.2 (E), Q503.2 (E), R201.2, R203.2, R205.1, R206.1, R207.1, R209.2, R210.2, R302.2, R305.2, R308.2, R318.2, R404.2, R405.2, R505.2, R513.2, U201.1A3 (VSS), U201.1A5 (VSS), U201.1A7 (VSS), U201.1B2 (VSS), U201.1B4 (VSS), U201.1B6 (VSS), U201.1B8 (VSS), U201.1C1 (VSS), U201.1C3 (VSS), U201.1C5 (VSS), U201.1C7 (VSS), U201.1C9 (VSS), U201.1D2 (VSS), U201.1D4 (VSS), U201.1D6 (VSS), U201.1D8 (VSS), U201.1E1 (VSS), U201.1E3 (VSS), U201.1E5 (VSS), U201.1E7 (VSS), U201.1E9 (VSS), U201.1F2 (VSS), U201.1F4 (VSS), U201.1F6 (VSS), U201.1F8 (VSS), U201.1G1 (VSS_ANA), U201.1G3 (VSS), U201.1G5 (VSS), U201.1G7 (VSS), U201.1G9 (VSS), U201.1H2 (VSSA), U201.1H4 (VSS), U201.1H6 (VSS), U201.1H8 (VSS), U201.1J3 (VSS), U201.1J5 (VSS), U201.1J7 (VSS), U201.A1 (VSS), U201.A23 (VSS), U201.AA5 (VSS), U201.AA8 (VSS), U201.AA12 (VSS), U201.AA16 (VSS_USBHS), U201.AA21 (VSS), U201.AB13 (BYPASS_REG1V8), U201.AC1 (VSS), U201.AC23 (VSS), U201.C7 (VSS), U201.C12 (VSS), U201.C16 (VSS), U201.C21 (VSS), U201.D4 (VSS), U201.F21 (VSS), U201.H3 (VSS), U201.K21 (VSS), U201.P3 (VSS), U201.P21 (VSS), U201.V21 (VSS), U201.W3 (VSS), U301.1 (GND), U302.2 (GND), U303.1 (GND), U304.1 (GND), U305.2 (V-), U306.2 (GND), U402.C2 (VSS), U402.C5 (VSS), U402.C6 (VSSQ), U402.C9 (VSSQ), U402.D1 (VSS), U402.D10 (VSSQ), U402.E1 (VSS), U402.E10 (VSSQ), U402.F5 (VSSQ), U402.G10 (VSSQ), U402.H2 (VSS), U402.J1 (VSS), U402.J5 (VSSQ), U402.J8 (VSS), U402.L10 (VSSQ), U402.M5 (VSSQ), U402.N1 (VSS), U402.N10 (VSSQ), U402.P1 (VSS), U402.P10 (VSSQ), U402.R2 (VSS), U402.R5 (VSS), U402.R6 (VSSQ), U402.R9 (VSSQ), U601.2 (GND), U601.5 (GND), U601.8 (STB2), U601.14 (STB1), U801.2 (GND), U1001.17 (GND), X201.2 (GND), X501.45 (XTAL_IN), X501.49 (GND)
unnamed: D201.1 (K), R211.2
unnamed: D301.2 (A), R311.2
unnamed: D301.1 (K), Q301.3 (C)
unnamed: D302.2 (A), R313.2
unnamed: D302.1 (K), Q302.3 (C)
unnamed: D303.2 (A), R312.2
unnamed: D303.1 (K), Q303.3 (C)
unnamed: D501.2 (BK), R508.2
unnamed: D501.3 (GK), R507.2
unnamed: D501.4 (RK), R506.2
unnamed: D502.2 (BK), R517.2
unnamed: D502.3 (GK), R516.2
unnamed: D502.4 (RK), R515.2
unnamed: CR601.2, FL601.2, J601.1
unnamed: CR601.1, FL601.3, J601.2
unnamed: J1002.5 (CLK), R1001.1, U1001.11 (CLK_Ex)
unnamed: J1002.3 (CMD), U1001.12 (CMD_Ex)
unnamed: J1002.7 (DAT0), U1001.10 (DAT0_Ex)
unnamed: J1002.8 (DAT1), U1001.9 (DAT1_Ex)
unnamed: J1002.1 (DAT2), U1001.14 (DAT2_Ex)
unnamed: J1002.2 (DAT3), U1001.13 (DAT3_Ex)
unnamed: Q301.1 (B), R303.1, U303.6 (PG)
unnamed: Q302.1 (B), R315.1, U301.6 (PG)
unnamed: Q303.1 (B), R306.1, U304.6 (PG)
unnamed: Q501.3 (C), R517.1
unnamed: Q502.3 (C), R516.1
unnamed: Q503.3 (C), R515.1
unnamed: R208.2, SW201.4, SW201.5, SW201.6
unnamed: R201.1, U201.K23 (DDR_ZQ)
unnamed: C227.2, U201.M4 (NRST_CORE)
unnamed: R211.1, U201.N2 (PA13)
unnamed: TP201.1 (1_1), U201.N3 (PWR_LP)
unnamed: C228.2, U201.AB15 (VDDA1V1_REG)
unnamed: C225.2, U201.R4 (VREF+)
unnamed: C331.2, R301.2, R302.1, U301.5 (FB)
unnamed: L306.2, U301.2 (SW)
unnamed: C304.2, R304.2, R305.1, U303.5 (FB)
unnamed: L301.2, U303.2 (SW)
unnamed: C337.2, R307.2, R308.1, U304.5 (FB)
unnamed: L308.2, U304.2 (SW)
unnamed: C307.1, R317.2, R318.1, U305.1 (+)
unnamed: R314.1, U305.3 (-)
unnamed: R404.1, U402.D3 (ZQ)
unnamed: FL601.1, U601.10 (CANH2), U601.13 (CANH1)
unnamed: FL601.4, U601.9 (CANL2), U601.12 (CANL1)
unnamed: R202.2, X201.1 (EN)
unnamed: C233.1, R204.2, X201.4 (V_{dd})
unnamed: R523.2, R534.2, X501.25 (CFG_{mode0})
unnamed: R522.2, X501.24 (CFG_{mode1})
unnamed: R521.2, X501.23 (CFG_{mode2})
unnamed: R537.2, X501.44 (CLKOUT)
unnamed: R503.2, R504.2, X501.14 (MDC)
unnamed: R526.2, X501.28 (PHYAD_{1})
unnamed: R525.2, X501.27 (PHYAD_{2})
unnamed: R520.2, X501.33 (PTP_CLKIN/GPIO_{0})
unnamed: R505.1, X501.48 (RSET)
unnamed: R524.2, X501.26 (RXDLY)
unnamed: R535.2, X501.21 (TXCLK)
unnamed: R532.2, X501.20 (TXCTL)
unnamed: R528.2, X501.19 (TXD_{0})
unnamed: R529.2, X501.18 (TXD_{1})
unnamed: R530.2, X501.17 (TXD_{2})
unnamed: R531.2, X501.16 (TXD_{3})
unnamed: R527.2, X501.46 (XTAL_OUT)
