Gregification/wm-top/(commit log)

2026-08-28 baseline of dev board
2026-09-19 bluh bluh
    [Inter-Board Connect.kicad_sch, LPDDR3 16b.kicad_sch, Power General.kicad_sch, ProcessorBoard_STM32MP153.kicad_pcb, ProcessorBoard_STM32MP153.kicad_sch, SPF.kicad_sch, ST Link off-board.kicad_sch, STM32MP153CAC.kicad_sch]
2026-09-20 piddling with power
    11 distinct power nets out :vine_boom:
    5V@8A in :vine_boom:
    3v3@3A in :vine_boom:
    secure os i2c :vine_boom:
    :vine_boom:
    :vine_boom:
    release me
    :vine_boom:
    these are absolute maximums the PMIC will need, shouldnt get near them unless the outputs shorted. big step up from the dinky 3v3 mcus :(
    [LPDDR3 16b.kicad_sch, Power General.kicad_sch, Power MPU.kicad_sch, ProcessorBoard_STM32MP153.kicad_pcb, ProcessorBoard_STM32MP153.kicad_sch, SPF.kicad_sch, STM32MP153CAC.kicad_sch, common_parts.kicad_sch]
2026-09-24 some more caps and power specs
    maybe puppy and rainbows if dont use the sw controlled PMIC. ddr dosent seem to care too much about sequencing, and the mpu sequence is 2 steps... but size :( :( :( . wheres muh leaded puckagies :(
    [LPDDR3 16b.kicad_sch, Power General.kicad_sch, Power MPU.kicad_sch, ProcessorBoard_STM32MP153.kicad_pcb, ProcessorBoard_STM32MP153.kicad_sch, STM32MP153CAC.kicad_sch, common_parts.kicad_sch, reference_parts.kicad_sch]
2026-09-25 pmic maybe
    caybe bees in the halls of 3d objects. post gimp utility. hp bug kit
    [Power MPU.kicad_sch]
2026-09-25 respeced caps
    everything out of stok :(
    [Power MPU.kicad_sch, reference_parts.kicad_sch]
2026-09-25 verified jlc price category
    ~[32, 50]usd for 5 boards. includes impedence control. though must be 1oz top & bottom layers, 0.5oz inner layers . goes up at least $10usd for different pours
    [LPDDR3 16b.kicad_sch, Power MPU.kicad_sch, ProcessorBoard_STM32MP153.kicad_pcb, ProcessorBoard_STM32MP153.kicad_sch, STM32MP153CAC.kicad_sch]
2026-09-26 mpu power connections
    about mpu, apparently onboard usb supply has a requirement for the onboard ldo's to be happy, so u have to tap out 2 deticated pins. and theres also a power off sequence as well???
    1v8 life looking better every day, 3v3(>2v9) trenches over there
    [LPDDR3 16b.kicad_sch, Power MPU.kicad_sch, ProcessorBoard_STM32MP153.kicad_pcb, ProcessorBoard_STM32MP153.kicad_sch, STM32MP153CAC.kicad_sch, reference_parts.kicad_sch]
2026-09-27 mr przudent get down
    a thrid DDR voltage requirement has hit the power plane.
    the cost of 11$ ram is apparently 3 distinct power nets :( .
    [LPDDR3 16b.kicad_sch, Power MPU.kicad_sch, ProcessorBoard_STM32MP153.kicad_pcb, ProcessorBoard_STM32MP153.kicad_sch, STM32MP153CAC.kicad_sch, reference_parts.kicad_sch]
2026-09-27 fanter
    dr pebba
    page 130
    hsul_12 come in clutch? no need for a bajillion power rails? Vtt become Vbye-bye
    [LPDDR3 16b.kicad_sch, Power MPU.kicad_sch]
2026-09-27 maybe working ddr
    datasheet dont lie but it also dont elaborate either
    [LPDDR3 16b.kicad_sch, Power MPU.kicad_sch]
2026-09-28 is this tuff
    most datasheets from LCSC are "not for public release"
    [LPDDR3 16b.kicad_sch, Power MPU.kicad_sch, ProcessorBoard_STM32MP153.kicad_pcb, ProcessorBoard_STM32MP153.kicad_sch, SPF.kicad_sch, STM32MP153CAC.kicad_sch, reference_parts.kicad_sch]
2026-09-30 crab company
    the lion does not concern himself with radiation
    [ProcessorBoard_STM32MP153.kicad_pcb, SPF.kicad_sch]
2026-10-02 big ol kicad file ?
    [LPDDR3 16b.kicad_sch, Power General.kicad_sch, Power MPU.kicad_sch, Power SPF.kicad_sch, ProcessorBoard_STM32MP153.kicad_sch, SPF.kicad_sch, STM32MP153CAC.kicad_sch, reference_parts.kicad_sch]
2026-10-04 new ram
    [LPDDR3 16b.kicad_sch, Power SPF.kicad_sch, ProcessorBoard_STM32MP153.kicad_pcb, ProcessorBoard_STM32MP153.kicad_sch, STM32MP153CAC.kicad_sch, reference_parts.kicad_sch, sd card.kicad_sch]
2026-10-05 realtek bridge thing somewhat more wired
    apparently the proper term for via skimping and what not is NFPR (non functional pad removal). all my homies love NFPR. so it is possible to route 0.5mm bga. still fighting the dog but at least cant bring it to another layer
    [LPDDR3 16b.kicad_sch, Power MPU.kicad_sch, Power SPF.kicad_sch, ProcessorBoard_STM32MP153.kicad_pcb, SPF.kicad_sch, STM32MP153CAC.kicad_sch, reference_parts.kicad_sch, sd card.kicad_sch]
2026-10-06 miled fixes
    [LPDDR3 16b.kicad_sch, Power MPU.kicad_sch, ProcessorBoard_STM32MP153.kicad_pcb, ProcessorBoard_STM32MP153.kicad_sch, STM32MP153CAC.kicad_sch]
2026-10-07 double inversion trap
    the crab has a double inversion, the pins internal logic is inverted. and the output logic-high is dynamically determined. bruh
    [LPDDR3 16b.kicad_sch, SPF.kicad_sch, reference_parts.kicad_sch]
2026-10-08 all hail the auto router
    https://ih1.redbubble.net/image.6083290940.2638/flat,750x,075,f-pad,750x1000,f8f8f8.jpg
    [LPDDR3 16b.kicad_sch, Power MPU.kicad_sch, Power SPF.kicad_sch, ProcessorBoard_STM32MP153.kicad_pcb, ProcessorBoard_STM32MP153.kicad_sch, SPF.kicad_sch, STM32MP153CAC.kicad_sch, reference_parts.kicad_sch]
2026-10-09 somewhat fanned
    the auto router sucks :( . and the auto fanout sucks. and i routed everything on the wrong grid and it snapped to teh wrong places and i only noticed most of teh way though so i push and make it tomorrows problem
    [LPDDR3 16b.kicad_sch, Power MPU.kicad_sch, ProcessorBoard_STM32MP153.kicad_pcb, SPF.kicad_sch, STM32MP153CAC.kicad_sch, reference_parts.kicad_sch]
2026-10-09 where ram :(
    its 56 connecitons (not including pwr and gnd) for x32 bus. not possible witout HDI or increasing layer count, both are big bucks. so long china ram. apparently winabond has some hidden gems and ebay smugglers as a supply chain. good stuff. and micron gatekeeps theyre datasheets.
    [LPDDR3 16b.kicad_sch, ProcessorBoard_STM32MP153.kicad_pcb, STM32MP153CAC.kicad_sch]
2026-10-10 2 layer ddr route. un tuned, missing pwr
    initial ddr rout done, not lenght tuned, only impedance matched. layer 1 completely free of traces, need to put power planes on it
    [LPDDR3 16b.kicad_sch, ProcessorBoard_STM32MP153.kicad_pcb, STM32MP153CAC.kicad_sch]
2026-10-12 found reference schematic :he he he ha:
    coincidence using the same chip !? am i tweaking or tamale-n brap
2026-10-13 i forgor track spacing :(
    need to redo ddr
2026-10-16 more traces. anything to avoid soldering
2026-10-17 shuffled core back to left side of board, fits better
    row row the power planes under mpu
2026-11-07 bom bloat
    last bkup for 1v8 logic. 3v3 make life easier, will try.
2026-11-08 3v3 seems to work better, incomplete transistion
    the layout got fugged, it looks like most vias that share a trace and a fill-zone of the same net got unassigned from their net; and DRC started failing?? only changed the schematic so good to know its poking. i can feel you yakub.
2026-11-09 sdmmc pin corrections
    tootle luee tootles ! (boo wamp)
